ts01af/Ultrasonic-water-depth-measurement/README.md

# Ultrasonic-water-depth-measurement
This repository will contain KiCad project for an ultrasonic water depth measurement platform

Masterthesis.kicad_pcb is the used pcb file
Masterthesis.kicad_sch is the used schematic file
