ts01af/Ultrasonic-water-depth-measurement/Mastersthesis/Mastersthesis.pdf

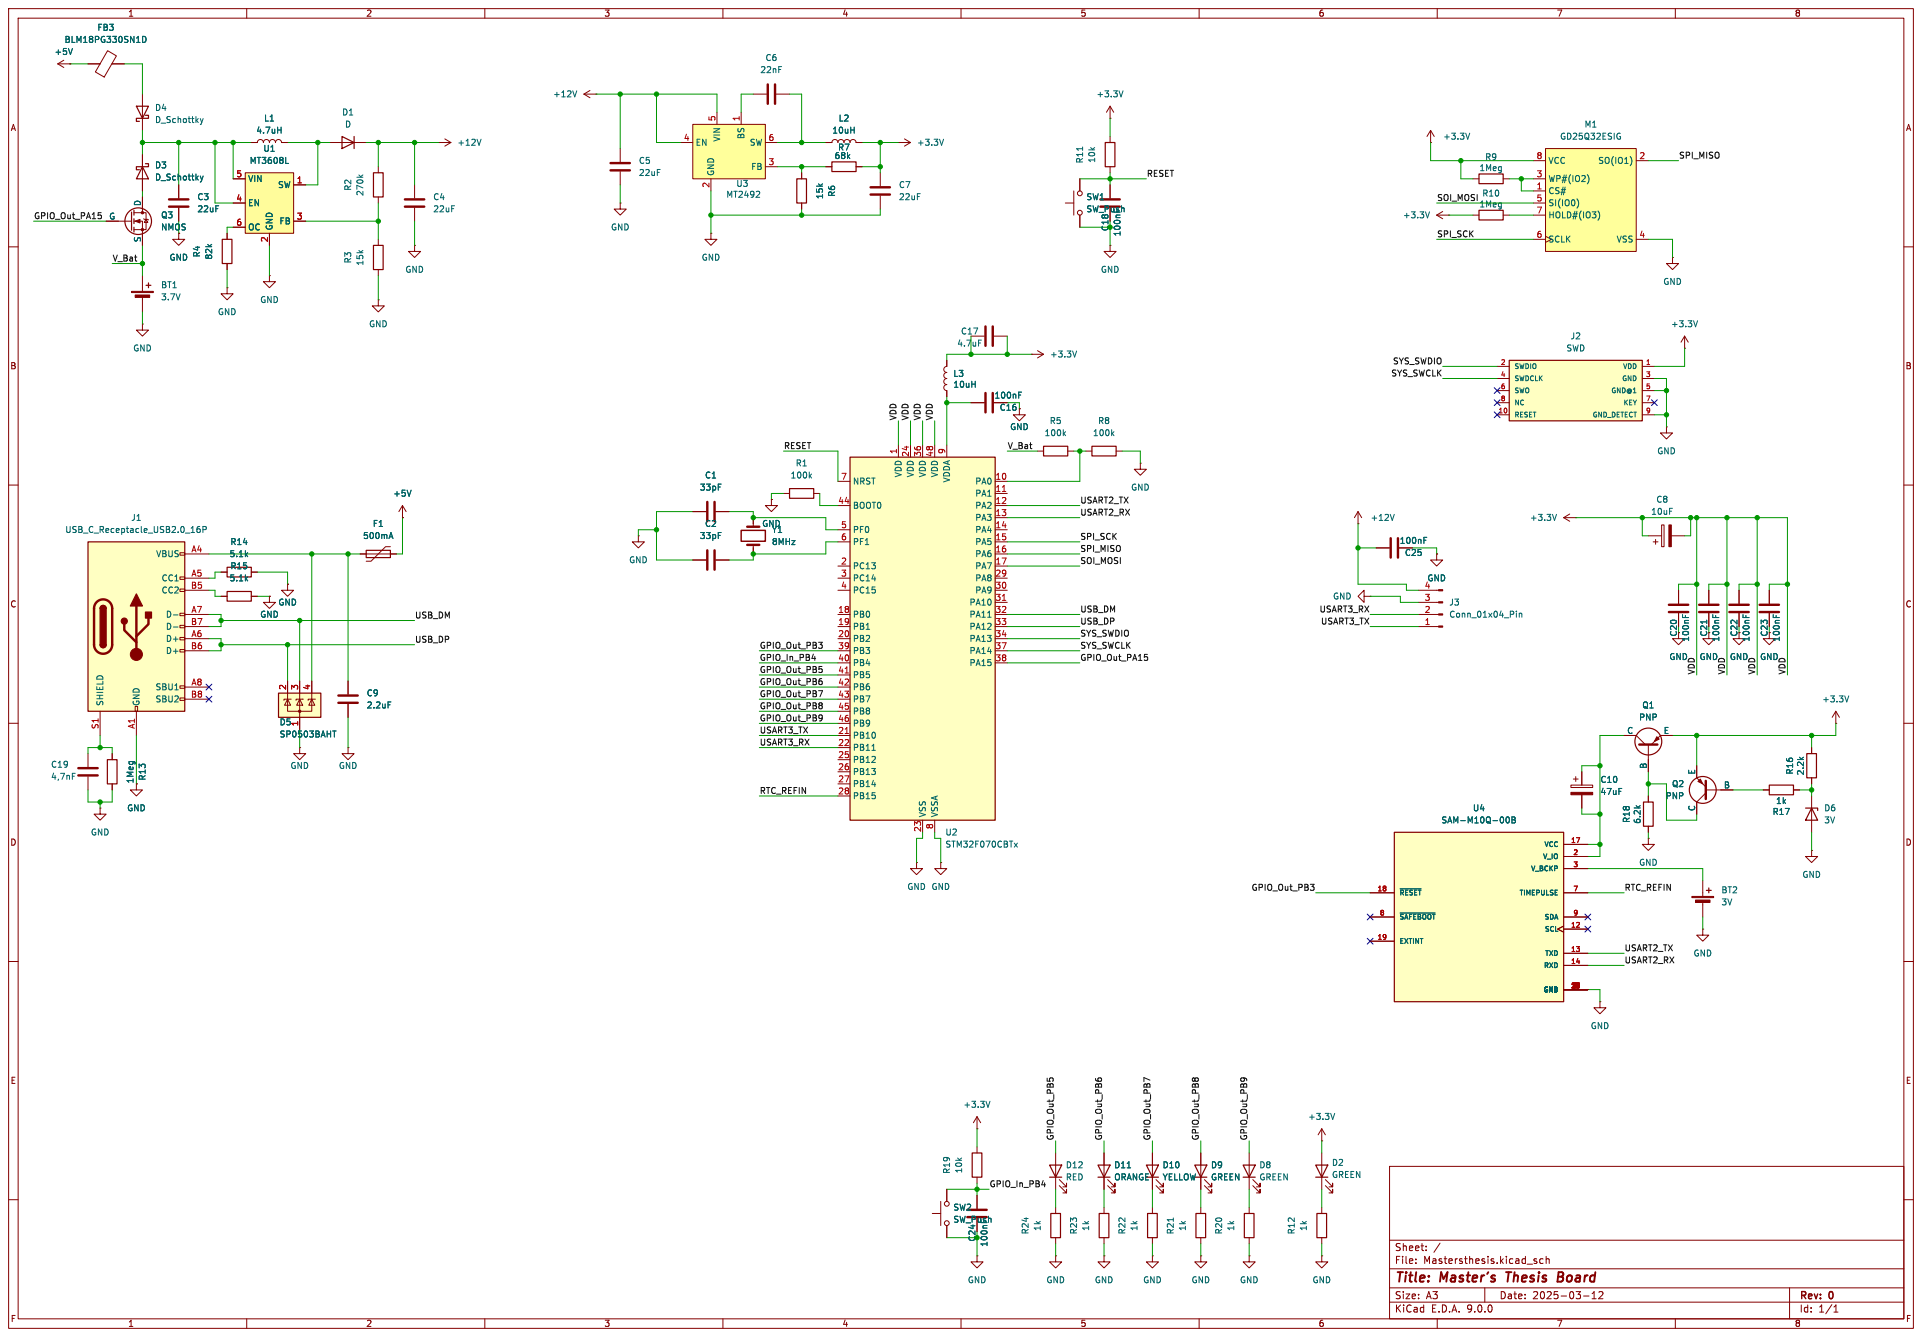
[picture p1: page 1]

1 SW 6 FB 3 U3 MT2492 C23 100nF SHIELD S1 GND A1 VBUS A4 CC1 A5 CC2 B5 D- A7 D- B7 D+ A6 D+ B6 SBU1 A8 SBU2 B8

1 VDD 24 VDD 36 VSS 23 VDD 48 VSSA

Id: 1/1 Title: Master's Thesis Board
