ts01af/Ultrasonic-water-depth-measurement/Mastersthesis/Mastersthesis.kicad_pcb

## KiCad design Mastersthesis/Mastersthesis.kicad_pcb (2025-07-24)

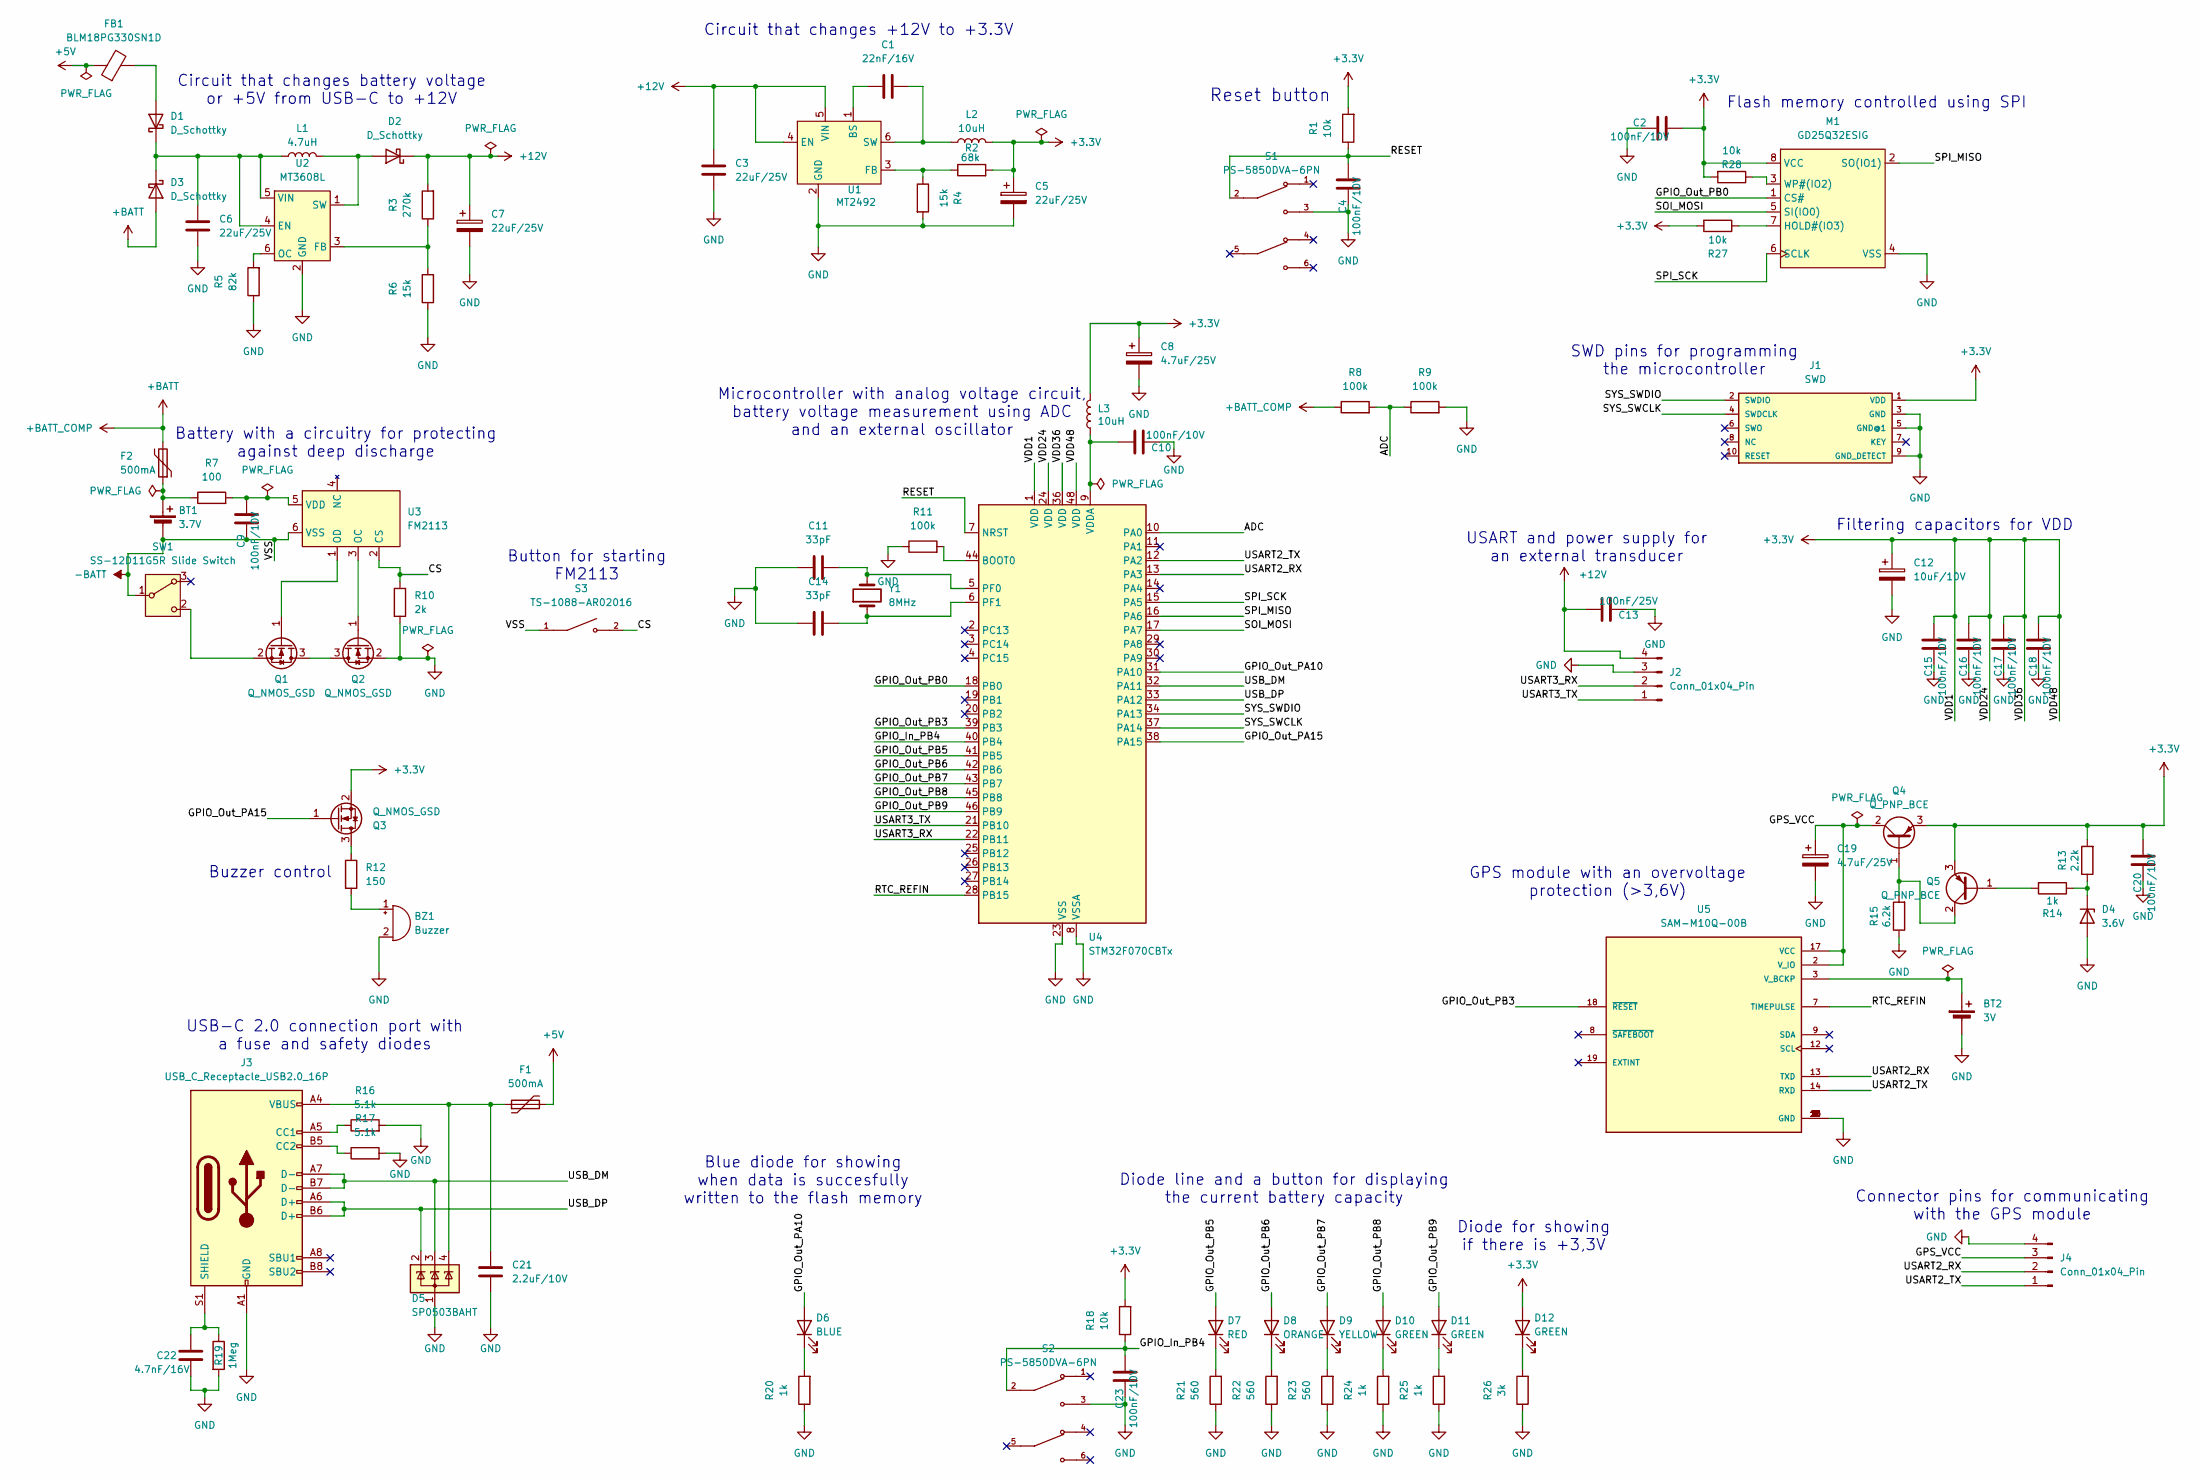
[picture p2: schematic Mastersthesis.kicad_sch, Master's Thesis Board]

Parts:
BT1: 3.7V; BatteryHolder_Keystone_1042_1x18650
BT2: 3V; BatteryHolder_Keystone_103_1x20mm
BZ1: Buzzer; CUI_CMI-9705-0580-SMT-TR
C1: 22nF/16V; C_0603_1608Metric
C2, C4, C9, C10, C15, C16, C17, C18, C20, C23: 100nF/10V; C_0603_1608Metric
C3, C6: 22uF/25V; C_1210_3225Metric
C5, C7: 22uF/25V; CP_Elec_5x5.4
C8, C19: 4.7uF/25V; CP_Elec_4x5.4
C11, C14: 33pF; C_0603_1608Metric
C12: 10uF/10V; CP_Elec_4x5.3
C13: 100nF/25V; C_0603_1608Metric
C21: 2.2uF/10V; C_0603_1608Metric
C22: 4.7nF/16V; C_0805_2012Metric
D1, D2, D3: D_Schottky; D_SOD-128
D4: 3.6V; D_SOD-123
D5: SP0503BAHT; SOT-143
D6: BLUE; LED_0805_2012Metric
D7: RED; LED_0805_2012Metric
D8: ORANGE; LED_0805_2012Metric
D9: YELLOW; LED_0805_2012Metric
D10, D11, D12: GREEN; LED_0805_2012Metric
F1, F2: 500mA; Fuse_0805_2012Metric
FB1: BLM18PG330SN1D; L_0603_1608Metric
J1: SWD; X1321WVS-2x05J-C40D53
J2, J4: Conn_01x04_Pin; PinHeader_1x04_P1.27mm_Vertical_SMD_Pin1Left
J3: USB_C_Receptacle_USB2.0_16P; USB_C_Receptacle_G-Switch_GT-USB-7010ASV
L1: 4.7uH; L_1008_2520Metric
L2, L3: 10uH; L_1008_2520Metric
M1: GD25Q32ESIG; SSOP-8_5.25x5.24mm_P1.27mm
Q1, Q2, Q3: Q_NMOS_GSD; SOT-23
Q4, Q5: Q_PNP_BCE; SOT-223-3_TabPin2
R1, R18, R27, R28: 10k; R_0603_1608Metric
R2: 68k; R_0603_1608Metric
R3: 270k; R_0603_1608Metric
R4, R6: 15k; R_0603_1608Metric
R5: 82k; R_0603_1608Metric
R7: 100; R_0603_1608Metric
R8, R9, R11: 100k; R_0603_1608Metric
R10: 2k; R_0603_1608Metric
R12: 150; R_0805_2012Metric
R13: 2.2k; R_0603_1608Metric
R14, R20, R24, R25: 1k; R_0805_2012Metric
R15: 6.2k; R_0603_1608Metric
R16, R17: 5.1k; R_0603_1608Metric
R19: 1Meg; R_0603_1608Metric
R21, R22, R23: 560; R_0805_2012Metric
R26: 3k; R_0805_2012Metric
S1, S2: PS-5850DVA-6PN; PARTREV E
S3: TS-1088-AR02016; SW_TS-1088-AR02016; PARTREV N/A
SW1: SS-12D11G5R Slide Switch
U1: MT2492; SOT-23-6
U2: MT3608L; SOT-23-6
U3: FM2113; SOT-23-6
U4: STM32F070CBTx; LQFP-48_7x7mm_P0.5mm
U5: SAM-M10Q-00B; XCVR_SAM-M10Q-00B; PARTREV R03
Y1: 8MHz; Crystal_SMD_HC49-SD

Connections:
+3.3V: C2.2, C5.1, C8.1, C12.1, C15.2, C16.2, C17.2, C18.2, C20.2, D12.2 (A), J1.1 (VDD), L2.2, L3.2, M1.8 (VCC), Q3.2 (S), Q4.3 (E), Q5.3 (E), R1.2, R2.2, R13.2, R18.2, R27.2, R28.2, U4.1 (VDD), U4.24 (VDD), U4.36 (VDD), U4.48 (VDD)
+5V: F1.2, FB1.1
+12V: C3.2, C7.1, C13.2, D2.1 (K), J2.4, R3.2, U1.4 (EN), U1.5 (VIN)
+BATT: D3.2 (A), F2.2, R8.1
-BATT: BT1.2 (-), C9.1, S3.1, SW1.1 (B), U3.6 (VSS)
/ADC: R8.2, R9.1, U4.10 (PA0)
/CS: R10.1, S3.2, U3.2 (CS)
/GPIO_In_PB4: C23.2, R18.1, S2.2, U4.40 (PB4)
/GPIO_Out_PA10: D6.2 (A), U4.31 (PA10)
/GPIO_Out_PA15: Q3.1 (G), U4.38 (PA15)
/GPIO_Out_PB0: M1.1 (CS#), U4.18 (PB0)
/GPIO_Out_PB3: U4.39 (PB3), U5.18 (~RESET)
/GPIO_Out_PB5: D7.2 (A), U4.41 (PB5)
/GPIO_Out_PB6: D8.2 (A), U4.42 (PB6)
/GPIO_Out_PB7: D9.2 (A), U4.43 (PB7)
/GPIO_Out_PB8: D10.2 (A), U4.45 (PB8)
/GPIO_Out_PB9: D11.2 (A), U4.46 (PB9)
/GPS_VCC: C19.1, J4.3, Q4.2 (C), U5.2 (V_IO), U5.17 (VCC)
/RESET: C4.2, R1.1, S1.2, U4.7 (NRST)
/RTC_REFIN: U4.28 (PB15), U5.7 (TIMEPULSE)
/SOI_MOSI: M1.5 (SI(IO0)), U4.17 (PA7)
/SPI_MISO: M1.2 (SO(IO1)), U4.16 (PA6)
/SPI_SCK: M1.6 (SCLK), U4.15 (PA5)
/SYS_SWCLK: J1.4 (SWDCLK), U4.37 (PA14)
/SYS_SWDIO: J1.2 (SWDIO), U4.34 (PA13)
/USART2_RX: J4.2, U4.13 (PA3), U5.13 (TXD)
/USART2_TX: J4.1, U4.12 (PA2), U5.14 (RXD)
/USART3_RX: J2.2, U4.22 (PB11)
/USART3_TX: J2.1, U4.21 (PB10)
/USB_DM: D5.3 (K), J3.A7 (D-), J3.B7 (D-), U4.32 (PA11)
/USB_DP: D5.2 (K), J3.A6 (D+), J3.B6 (D+), U4.33 (PA12)
GND: BT2.2 (-), BZ1.2 (-), C2.1, C3.1, C4.1, C5.2, C6.1, C7.2, C8.2, C10.1, C11.1, C12.2, C13.1, C14.1, C15.1, C16.1, C17.1, C18.1, C19.2, C20.1, C21.1, C22.2, C23.1, D4.2 (A), D5.1 (A), J1.3 (GND), J1.5 (GND@1), J1.9 (GND_DETECT), J2.3, J3.A1 (GND), J3.A12 (GND), J3.B1 (GND), J3.B12 (GND), J4.4, M1.4 (VSS), Q2.2 (S), R4.2, R5.1, R6.1, R9.2, R10.2, R11.1, R15.1, R16.2, R17.2, R19.2, R20.1, R21.1, R22.1, R23.1, R24.1, R25.1, R26.1, S1.3, S2.3, U1.2 (GND), U2.2 (GND), U4.8 (VSSA), U4.23 (VSS), U4.35 (VSS), U4.47 (VSS), U5.1 (GND), U5.4 (GND), U5.5 (GND), U5.6 (GND), U5.10 (GND), U5.11 (GND), U5.15 (GND), U5.16 (GND), U5.20 (GND)
unnamed: BT1.1 (+), F2.1, R7.1
unnamed: BT2.1 (+), U5.3 (V_BCKP)
unnamed: BZ1.1 (+), R12.2
unnamed: C21.2, D5.4 (K), F1.1, J3.A4 (VBUS), J3.A9 (VBUS), J3.B4 (VBUS), J3.B9 (VBUS)
unnamed: D1.2 (A), FB1.2
unnamed: C6.2, D1.1 (K), D3.1 (K), L1.1, U2.4 (EN), U2.5 (VIN)
unnamed: D2.2 (A), L1.2, U2.1 (SW)
unnamed: D4.1 (K), R13.1, R14.1
unnamed: D6.1 (K), R20.2
unnamed: D7.1 (K), R21.2
unnamed: D8.1 (K), R22.2
unnamed: D9.1 (K), R23.2
unnamed: D10.1 (K), R24.2
unnamed: D11.1 (K), R25.2
unnamed: D12.1 (K), R26.2
unnamed: J3.A5 (CC1), R16.1
unnamed: J3.B5 (CC2), R17.1
unnamed: C22.1, J3.S1 (SHIELD), R19.1
unnamed: M1.7 (HOLD#(IO3)), R27.1
unnamed: M1.3 (WP#(IO2)), R28.1
unnamed: Q1.3 (D), Q2.3 (D)
unnamed: Q1.1 (G), U3.1 (OD)
unnamed: Q1.2 (S), SW1.2 (C)
unnamed: Q2.1 (G), U3.3 (OC)
unnamed: Q3.3 (D), R12.1
unnamed: Q4.1 (B), Q5.2 (C), R15.2
unnamed: Q5.1 (B), R14.2
unnamed: C1.2, U1.1 (BS)
unnamed: R2.1, R4.1, U1.3 (FB)
unnamed: C1.1, L2.1, U1.6 (SW)
unnamed: R3.1, R6.2, U2.3 (FB)
unnamed: R5.2, U2.6 (OC)
unnamed: C9.2, R7.2, U3.5 (VDD)
unnamed: R11.2, U4.44 (BOOT0)
unnamed: C11.2, U4.5 (PF0), Y1.2
unnamed: C14.2, U4.6 (PF1), Y1.1
unnamed: C10.2, L3.1, U4.9 (VDDA)

Notes on the sheet:
Connector pins for communicating with the GPS module
SWD pins for programming the microcontroller
Circuit that changes +12V to +3.3V
Microcontroller with analog voltage circuit, battery voltage measurement using ADC and an external oscillator
Circuit that changes battery voltage or +5V from USB-C to +12V
GPS module with an overvoltage protection (>3,6V)
Button for starting FM2113
Buzzer control
Flash memory controlled using SPI
Diode line and a button for displaying the current battery capacity
Filtering capacitors for VDD
Blue diode for showing when data is succesfully written to the flash memory
USART and power supply for an external transducer
Diode for showing if there is +3,3V
Reset button
Battery with a circuitry for protecting against deep discharge
USB-C 2.0 connection port with a fuse and safety diodes

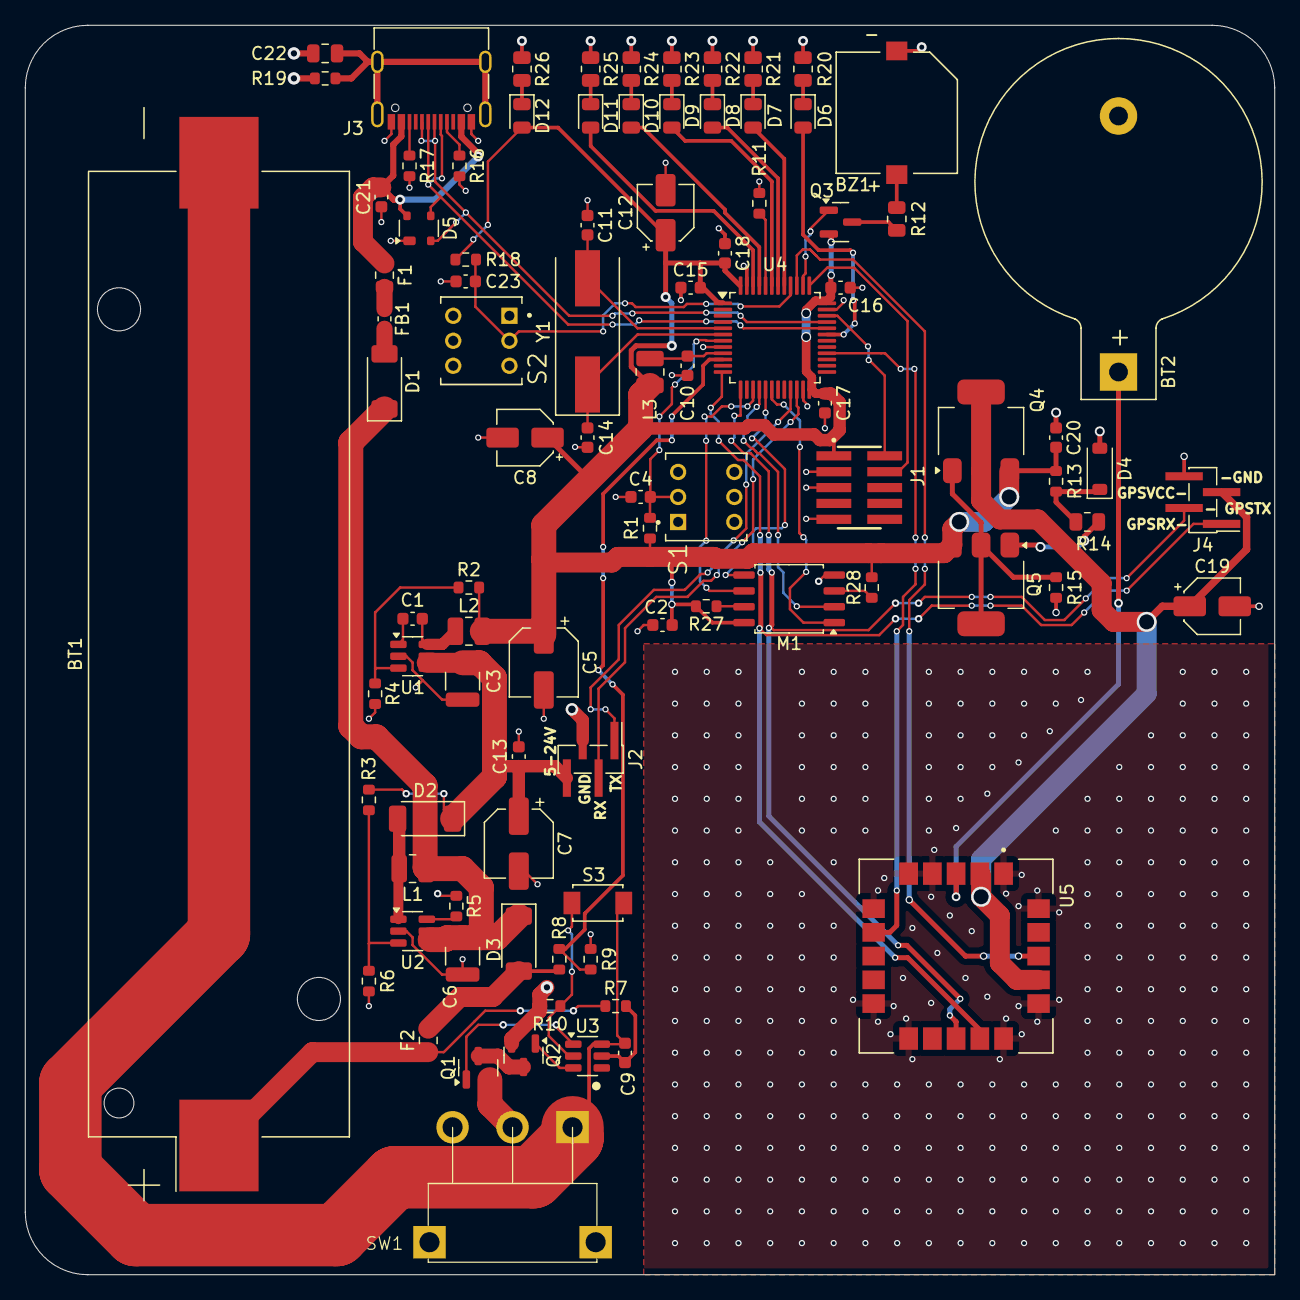
[picture p3: board Mastersthesis.kicad_pcb from above]

Board: 2 copper layers, 100.0 x 100.0 mm, 92 parts (0 on the bottom side), 69 nets.
